szuco/open.sprinkler/README.md

# Sz Open Sprinkler Extension Project

Software, Hardware and Construction extensions will be added here
