szuco/open.sprinkler/hw/case/TIAO_OpensprinklerPi_Case/images/1b1b30183512e37f272467fa98b55c4a_preview_featured.jpg

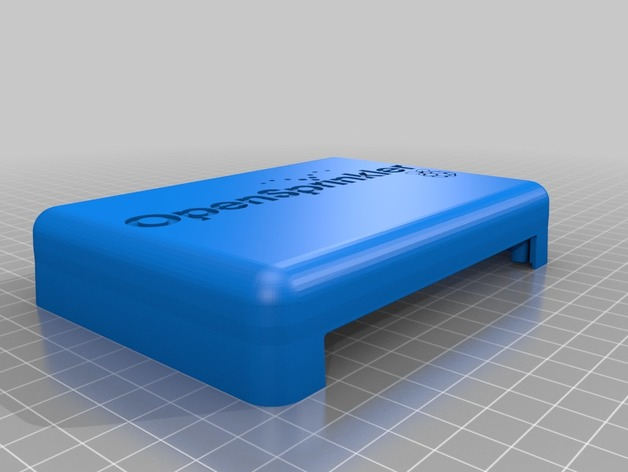
hw/case/TIAO_OpensprinklerPi_Case/images/1b1b30183512e37f272467fa98b55c4a_preview_featured.jpg
