szuco/open.sprinkler/hw/case/TIAO_OpensprinklerPi_Case/images/a8221d5725c551981892c6711ea7e16f_preview_featured.jpg

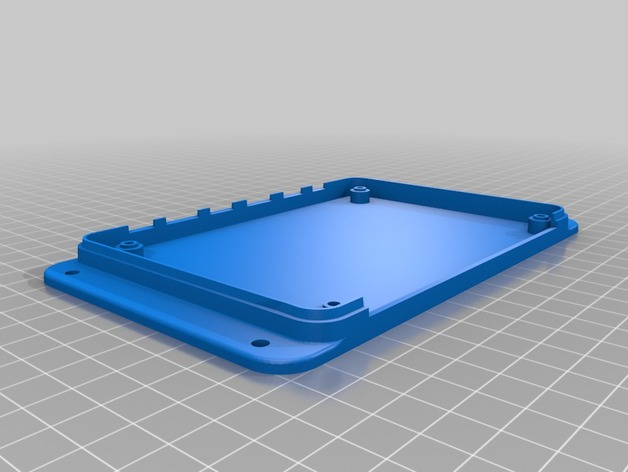
hw/case/TIAO_OpensprinklerPi_Case/images/a8221d5725c551981892c6711ea7e16f_preview_featured.jpg
