szuco/open.sprinkler/hw/case/OpenSprinkler_DecorCover/CoverFrame.stl

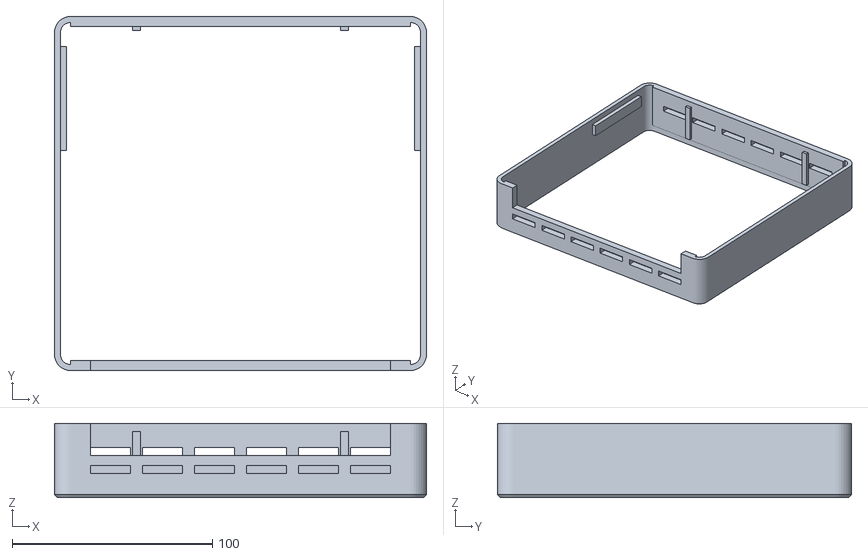
[picture p6: CAD file, 2026-09-06]
hw/case/OpenSprinkler_DecorCover/CoverFrame.stl
186.0 x 177.0 x 37.0
