szuco/open.sprinkler/hw/case/OpenSprinkler_PI_TIAO_Case/files/opensprinkler_lid.stl

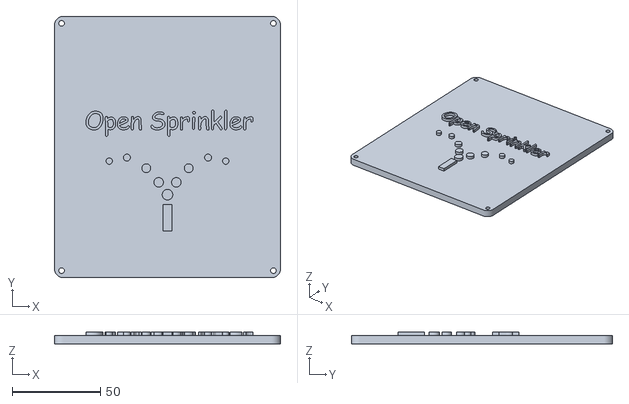
[picture p7: CAD file, 2021-09-11]
hw/case/OpenSprinkler_PI_TIAO_Case/files/opensprinkler_lid.stl
128.0 x 148.0 x 7.00
