szuco/open.sprinkler/hw/case/TIAO_OpensprinklerPi_Case/files/OpensprinklerPi_Bottom_Case_Cover.stl

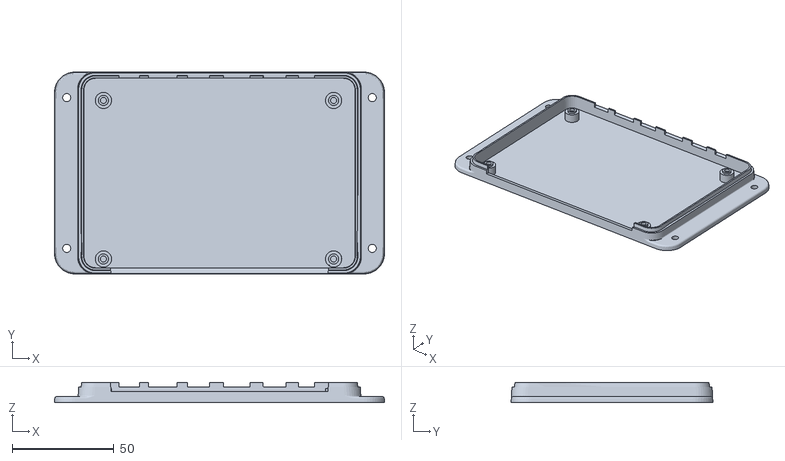
[picture p8: CAD file, 2021-09-11]
hw/case/TIAO_OpensprinklerPi_Case/files/OpensprinklerPi_Bottom_Case_Cover.stl
162.0 x 99.1 x 10.0
