szuco/open.sprinkler/hw/case/OpenSprinkler_DecorCover/OpenSprinklerCover.FCStd

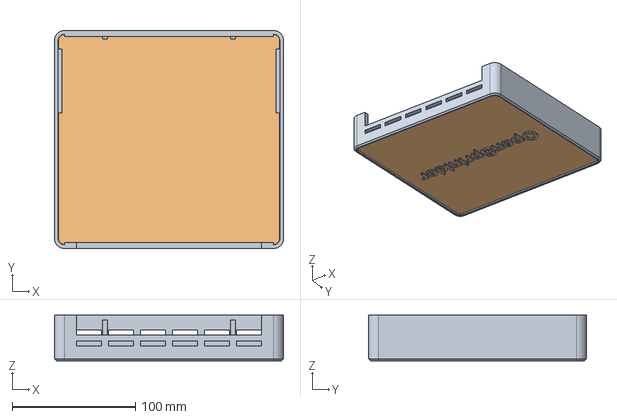
[picture p9: CAD file, 2026-09-06]
hw/case/OpenSprinkler_DecorCover/OpenSprinklerCover.FCStd
186.0 x 177.0 x 37.0 mm
CoverFrame
FrontPlate
