szuco/open.sprinkler/hw/case/TIAO_OpensprinklerPi_Case/files/OpensprinklerPi_Top_Cover.stl

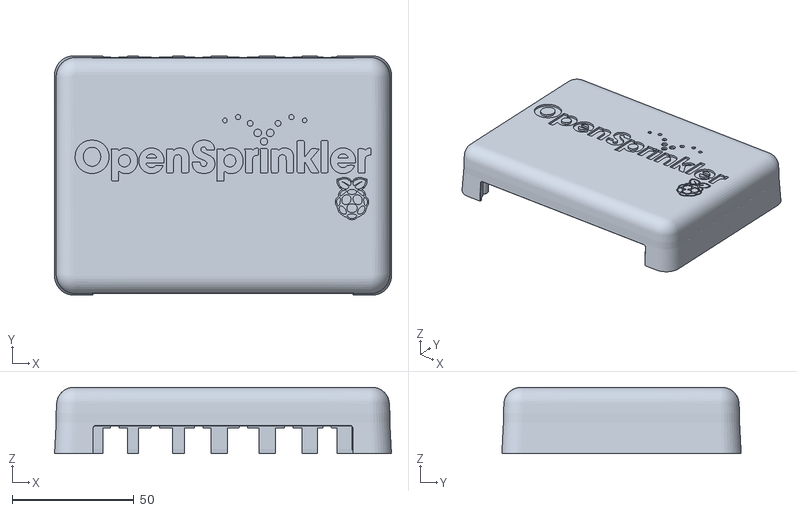
[picture p10: CAD file, 2021-09-11]
hw/case/TIAO_OpensprinklerPi_Case/files/OpensprinklerPi_Top_Cover.stl
138.3 x 98.2 x 27.2
