szuco/open.sprinkler/hw/case/OpenSprinkler_DecorCover/FrontPlate.stl

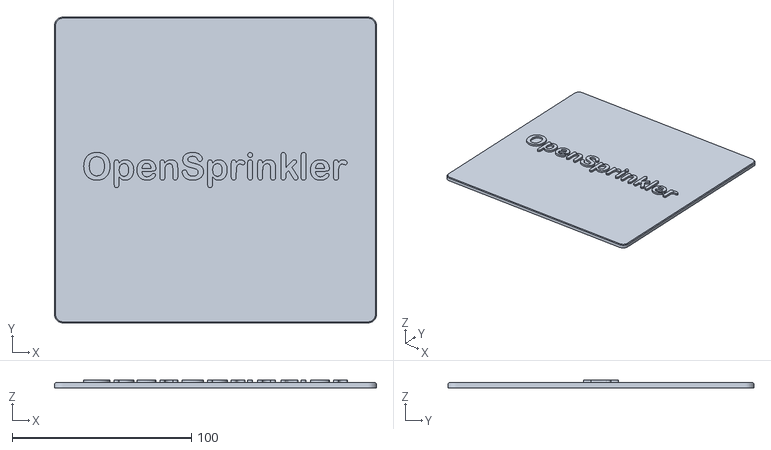
[picture p11: CAD file, 2026-09-06]
hw/case/OpenSprinkler_DecorCover/FrontPlate.stl
179.5 x 170.5 x 4.40
