szuco/open.sprinkler/(commit log)

2026-08-26 Add parametric FreeCAD design cover for OpenSprinkler v3
    Two-part slip-over decorative cover (frame + front plate with raised
    "OpenSprinkler" relief) that hides the side/bottom connectors, mounting
    tabs and wiring. Includes FreeCAD macro, FCStd document, print-ready
    STLs, preview renders and German documentation.
    [CoverFrame.stl, FrontPlate.stl, OpenSprinklerCover.FCStd]
2026-09-02 Resize decor cover to fit the wall-mounted unit
    The cover was dimensioned from the bare OpenSprinkler v3 STEP model, which
    is smaller than what is actually mounted on the wall (printed enclosure plus
    back plate with mounting wings). Measured from photos of the installation:
    ~172 mm wide over the wings, ~100 mm tall, terminal blocks and the wall
    opening reaching ~38 mm below the case, and a lever connector sticking out
    on the left side.
    - Parameters now describe the installed unit: CASE_W/CASE_H/CASE_D and
    COVER_BELOW instead of bare-case dimensions.
    - Outer size 172x133x42.5 -> 188x162x48.5 mm, cavity 182x152 mm.
    - Side clearance 2 -> 5 mm so the hood clears the lever connector.
    - Skirt 2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
    [CoverFrame.stl, FrontPlate.stl, OpenSprinklerCover.FCStd]
2026-09-06 Drive cover size from measured minimum clearances
    Measured requirements from the installation: at least 170 mm clear width,
    160 mm of coverage below the top edge of the unit, and 25 mm clear depth.
    The parameter block now states those three minima directly (CLEAR_W,
    CLEAR_DROP, CLEAR_D) with separate allowances on top (ADD_W, ADD_DROP,
    ADD_D), so the required values are guaranteed rather than implied by a
    chain of case dimensions. The macro prints required vs. actual at the end.
    - Outer size 188x162x48.5 -> 186x177x37 mm; clear space 180 mm wide,
    165 mm down from the top edge, 32 mm deep.
    - Depth drops from 42.5 to 32 mm clear, matching the measured 25 mm plus
    7 mm for the cable bend.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
    [CoverFrame.stl, FrontPlate.stl, OpenSprinklerCover.FCStd]
2026-09-06 Document how the cover sits on the original enclosure
    Adds an assembly figure (exploded view plus a dimensioned side section) and
    spells out the retention: the cover does not clamp, it hangs on two support
    ribs on top of the enclosure and leans its rear rim against the wall, with
    about 2 mm of lateral play left by the centring ribs. Nothing holds it
    against being lifted or pulled forward, which is intentional.
    The enclosure in the figure is a stand-in built from the measured 170 x 100
    x 25 mm, not real geometry - the v3 enclosure model is not in this repo.
